hasanmertsoycan/Digital-Security-and-Access-Control-System/README.md

# 🔐 Digital Security and Access Control System – FPGA Project

This project implements a password-protected digital door lock system using VHDL on a Basys 3 FPGA board. It includes password authentication, servo-based door unlocking, alarm triggering, and motion-activated lighting using peripheral components.

## 🧠 Features

- 4-digit password entry via 4x4 matrix keypad  
- Servo motor unlocks door on correct password  
- 3-strike alarm system (buzzer + LEDs) on incorrect entries  
- 7-segment display feedback for input  
- PIR motion sensor controls an external LED  
- Input validation via FSM structure  
- All components built using modular VHDL design

## 🧰 Technologies

- **Platform**: Basys 3 FPGA (Xilinx Artix-7)  
- **Language**: VHDL  
- **Tools**: Xilinx Vivado  
- **Core**: Finite State Machine (FSM) design

## 📝 Report

The full project report is available in the main directory:
📄 [Digital Security and Access Control System Report (PDF)](./Digital%20Security%20and%20Access%20Control%20System%20Report.pdf)

## 👤 Author

Hasan Mert Soycan  
Undergraduate Student – Bilkent University, Electrical and Electronics Engineering  
📧 hasanmertsoycan@gmail.com  
🔗 [LinkedIn](https://www.linkedin.com/in/hasanmertsoycan)
